raphaelabrams/solarbrain/Solarbrain.brd

## EAGLE design Solarbrain.brd (2013-01-02)

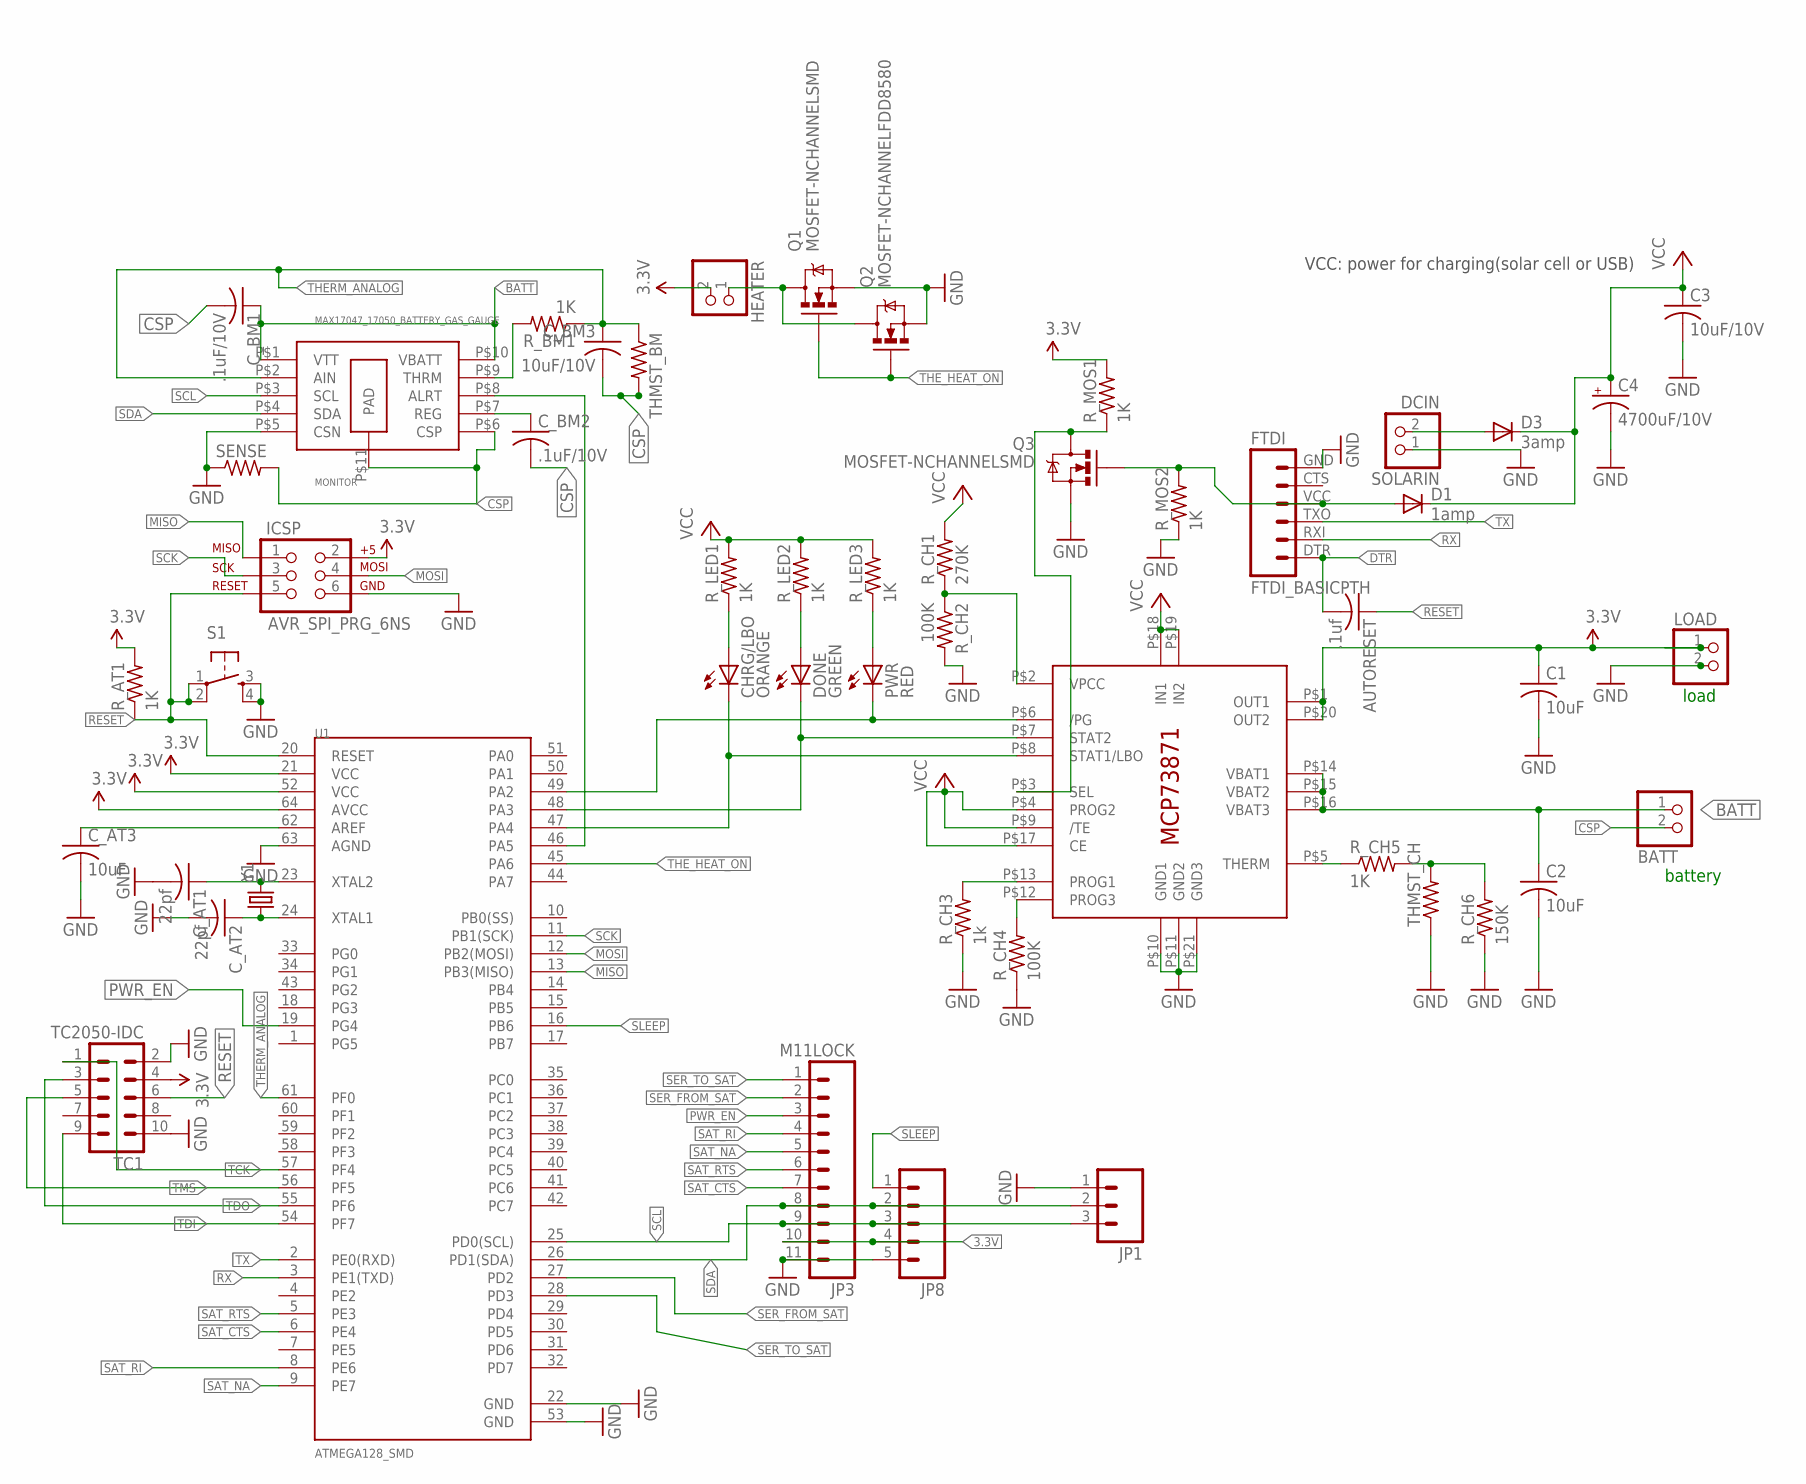
[picture p1: schematic Solarbrain.sch]

Parts:
AUTORESET: .1uf; C0603
BATT: JST_2PIN-SMT-RA; JST-PH-2-SMT-RA
C1: 10uF; C0603
C2: 10uF; C0805K
C3: 10uF/10V; C0603
C4: 4700uF/10V; PANASONIC_G
CHRG/LBO: ORANGE; CHIP-LED0603
C_AT1: 22pf; C0603K
C_AT2: 22pf; C0603
C_AT3: 10uF; C0805K
C_BM1, C_BM2: .1uF/10V; C0603
C_BM3: 10uF/10V; C0603
D1: 1amp; SMA-DIODE
D3: 3amp; SMA-DIODE
DONE: GREEN; CHIP-LED0603
FTDI: FTDI_BASICPTH; FTDI_BASIC
HEATER: HEADER-1X2ROUND; 1X02_ROUND
IC1: MCP73871; QFN20_4MM
ICSP: AVR_SPI_PRG_6NS; 2X3-NS
JP1: M03PTH; 1X03
JP3: M11LOCK; 1X11_LOCK
JP8: M05LOCK; 1X05_LOCK
LOAD: HEADER-1X2ROUND; 1X02_ROUND
MONITOR: MAX17047_17050_BATTERY_GAS_GAUGE; TDFN_10_3X3MM
PWR: RED; CHIP-LED0603
Q1, Q3: MOSFET-NCHANNELSMD; SOT23-3
Q2: MOSFET-NCHANNELFDD8580; DPAK
R_AT1: 1K; R0603
R_BM1: 1K; R0603
R_CH1: 270K; R0603
R_CH2, R_CH4: 100K; R0603
R_CH3: 1k; R0603
R_CH5: 1K; R0603
R_CH6: 150K; R0603
R_LED1, R_LED2, R_LED3: 1K; R0603
R_MOS1, R_MOS2: 1K; R0603
S1: TAC_SWITCHSMD; TACTILE_SWITCH_SMD
SENSE: R-US_R3225; R3225
SOLARIN: DCIN; 1X02_ROUND
TC1: TC2050-IDC
THMST_BM: R-US_R0603; R0603
THMST_CH: R-US_R0603; R0603
U1: ATMEGA128_SMD; TQFP64
Y1: CRYSTAL5X3; CRYSTAL-SMD-5X3

Connections:
3.3V: C1.1, HEATER.2, IC1.P$1 (OUT1), IC1.P$20 (OUT2), ICSP.2, JP3.10, JP8.4, LOAD.1, R_AT1.2, R_MOS1.2, TC1.4, U1.21 (VCC), U1.52 (VCC), U1.64 (AVCC)
#PG: IC1.P$6 (/PG), PWR.C, U1.49 (PA2)
BATT: BATT.1 (2), C2.1, C_BM1.1, IC1.P$14 (VBAT1), IC1.P$15 (VBAT2), IC1.P$16 (VBAT3), MONITOR.P$1 (VTT), MONITOR.P$10 (VBATT)
CSP: BATT.2 (1), C_BM1.2, C_BM2.2, C_BM3.2, MONITOR.P$6 (CSP), MONITOR.P$11 (PAD), SENSE.2, THMST_BM.2
DTR: AUTORESET.2, FTDI.DTR (1)
GND: C1.2, C2.2, C3.2, C4.-, C_AT1.2, C_AT2.2, C_AT3.2, FTDI.GND (6), IC1.P$10 (GND1), IC1.P$11 (GND2), IC1.P$21 (GND3), ICSP.6, JP1.1, JP3.11, JP8.5, LOAD.2, MONITOR.P$5 (CSN), Q1.2 (S), Q2.3 (S), Q3.2 (S), R_CH2.2, R_CH3.1, R_CH4.1, R_CH6.1, R_MOS2.1, S1.3, S1.4, SENSE.1, SOLARIN.1, TC1.2, TC1.10, THMST_CH.1, U1.22 (GND), U1.53 (GND), U1.63 (AGND)
MISO: ICSP.1, U1.13 (PB3(MISO))
MOSI: ICSP.4, U1.12 (PB2(MOSI))
unnamed: D1.A, FTDI.VCC (4), Q3.1 (G), R_MOS2.2
unnamed: C_AT1.1, U1.23 (XTAL2), Y1.3 (2)
unnamed: IC1.P$5 (THERM), R_CH5.1
unnamed: R_CH5.2, R_CH6.2, THMST_CH.2
unnamed: C_AT2.1, U1.24 (XTAL1), Y1.1
unnamed: CHRG/LBO.A, R_LED1.1
unnamed: DONE.A, R_LED2.1
unnamed: PWR.A, R_LED3.1
unnamed: MONITOR.P$8 (ALRT), U1.46 (PA5)
unnamed: C_AT3.1, U1.62 (AREF)
unnamed: HEATER.1, Q1.3 (D), Q2.4 (D)
unnamed: MONITOR.P$9 (THRM), R_BM1.2
unnamed: D3.A, SOLARIN.2
unnamed: C_BM2.1, MONITOR.P$7 (REG)
PROG1: IC1.P$13 (PROG1), R_CH3.2
PROG3: IC1.P$12 (PROG3), R_CH4.2
PWR_EN: JP3.3, U1.19 (PG4)
RESET: AUTORESET.1, ICSP.5, R_AT1.1, S1.1, S1.2, TC1.6, U1.20 (RESET)
RX: FTDI.RXI (2), U1.3 (PE1(TXD))
SAT_CTS: JP3.7, U1.6 (PE4)
SAT_NA: JP3.5, U1.9 (PE7)
SAT_RI: JP3.4, U1.8 (PE6)
SAT_RTS: JP3.6, U1.5 (PE3)
SCK: ICSP.3, U1.11 (PB1(SCK))
SCL: JP1.3, JP3.9, JP8.3, MONITOR.P$3 (SCL), U1.25 (PD0(SCL))
SDA: JP1.2, JP3.8, JP8.2, MONITOR.P$4 (SDA), U1.26 (PD1(SDA))
SEL: IC1.P$3 (SEL), Q3.3 (D), R_MOS1.1
SER_FROM_SAT: JP3.2, U1.27 (PD2)
SER_TO_SAT: JP3.1, U1.28 (PD3)
SLEEP: JP8.1, U1.16 (PB6)
STAT1: CHRG/LBO.C, IC1.P$8 (STAT1/LBO), U1.47 (PA4)
STAT2: DONE.C, IC1.P$7 (STAT2), U1.48 (PA3)
TCK: TC1.1, U1.57 (PF4)
TDI: TC1.9, U1.54 (PF7)
TDO: TC1.3, U1.55 (PF6)
THERM_ANALOG: C_BM3.1, MONITOR.P$2 (AIN), R_BM1.1, THMST_BM.1, U1.61 (PF0)
THE_HEAT_ON: Q1.1 (G), Q2.1 (G), U1.45 (PA6)
TMS: TC1.5, U1.56 (PF5)
TX: FTDI.TXO (3), U1.2 (PE0(RXD))
VCC: C3.1, C4.+, D1.C, D3.C, IC1.P$4 (PROG2), IC1.P$9 (/TE), IC1.P$17 (CE), IC1.P$18 (IN1), IC1.P$19 (IN2), R_CH1.2, R_LED1.2, R_LED2.2, R_LED3.2
VPCC: IC1.P$2 (VPCC), R_CH1.1, R_CH2.1

Notes on the sheet:
load
battery
VCC: power for charging(solar cell or USB)

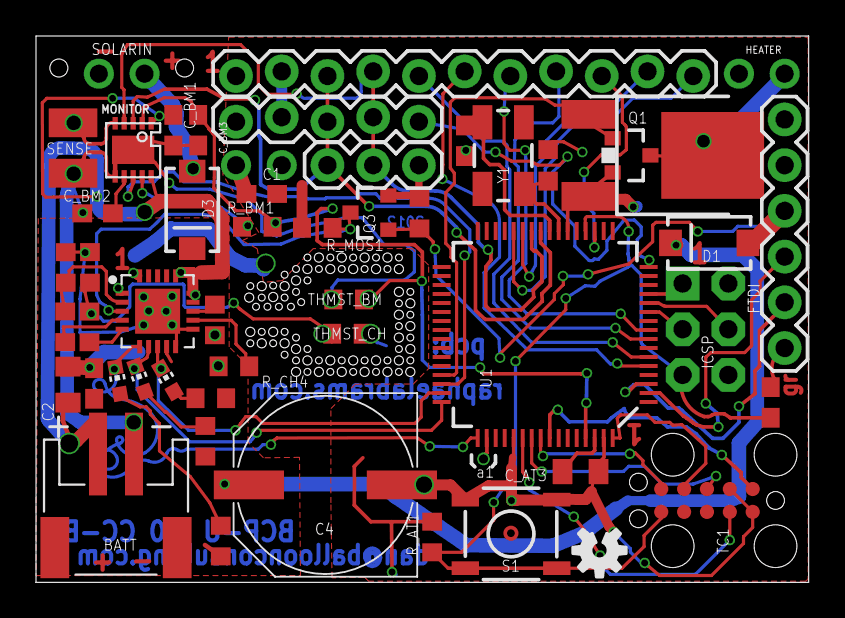
[picture p2: board Solarbrain.brd from above]

Board: 2 copper layers, 42.9 x 30.4 mm, 51 parts (0 on the bottom side), 49 nets.

Other parts of the board:
U$1: OSHW-LOGO-S
