raphaelabrams/solarbrain/(commit log)

2012-12-20 first commit. Made board, schematic and project file. Probably can delete project file.
    [Solarbrain.brd, Solarbrain.sch]
2012-12-20 fixed a broken connection, clarification on schematic
    [Solarbrain.brd, Solarbrain.sch]
2012-12-20 minor tweaks on board, added a via to get to an extra IO pin (pa1)
    [Solarbrain.brd]
2013-01-02 major tweak list
    issues addressed:
    * Atmega Circuit
    1. PWR_EN from sat connector net not connected to any I/O pin on
    ATMega
    * Fuel Gauge Circuit
    1. VBATT (BATT) voltage sense trace for the MAX17047 should be a
    Kelvin connection - needs to be split and routed separately from the
    current carrying portion of trace to a point close to the battery input
    2. CVBATT (C_BM1) should be connected to VBATT's separate kelvin
    line and PK-/CSP, not to main current carrying line and GND
    3. CREG (C_BM2) capacitor should be connected to PK-/CSP not GND.
    (Figs 5 and 8 data sheet)
    4. THMST_BM should be connected to PK-/CSP- not GND (Fig 5 data
    sheet)
    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
    [Solarbrain.brd, Solarbrain.sch]
