raphaelabrams/solarbrain/(notices)

Notices in the files:
Solarbrain.brd:
BCP-U 1.0 CC-BY
parts and their libraries:
SparkFun2011: Licensing: CC v3.0 Share-Alike You are welcome to use this library for commercial purposes.
